JChuy0/CustomClock/images/clock_1.jpg

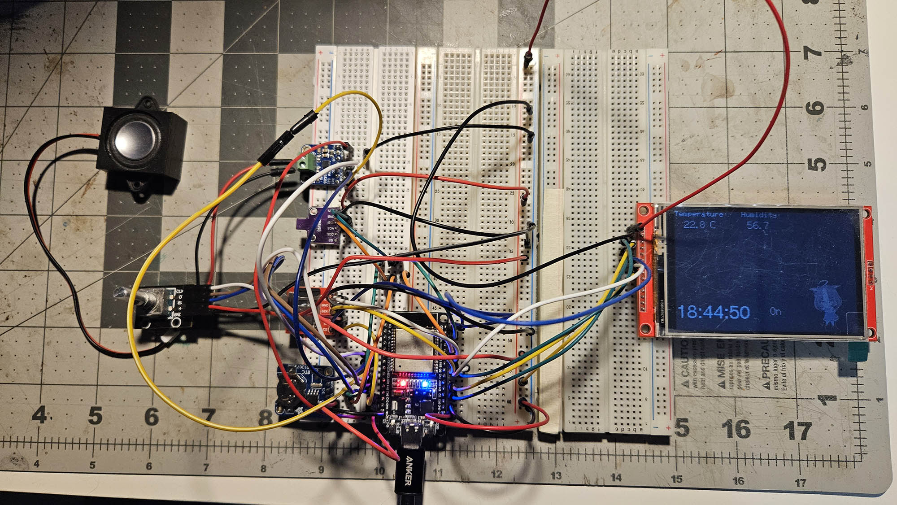
images/clock_1.jpg
