JChuy0/CustomClock/images/clock_flowchart.png

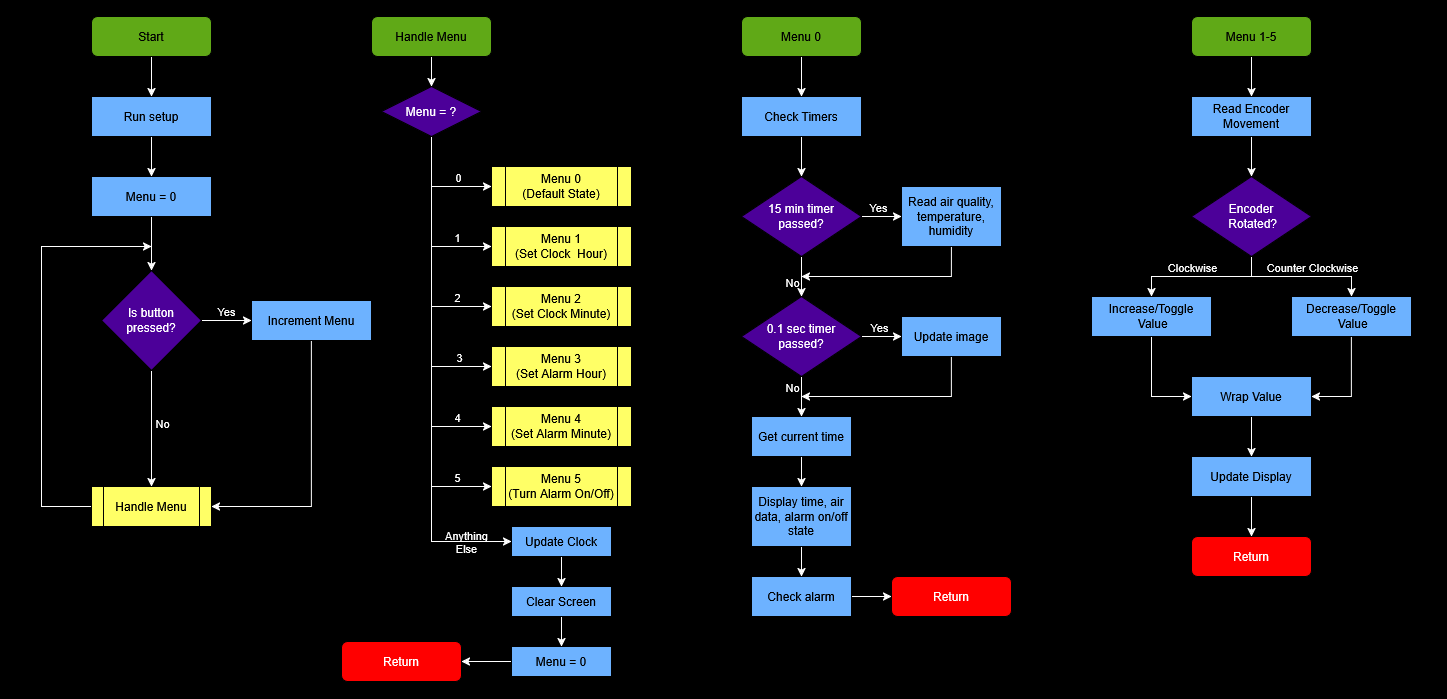
images/clock_flowchart.png
