JChuy0/CustomClock/Bill Of Materials.ods

Sheet: BOM
Digikey Part Number | Manuf Part Number | Part Name | Qty | Voltage | Communication Protocol | Datasheets
N/A |  | ESP-WROOM-32 Dev Board | 1 | 3.3v | N/A
1528-1788-ND | 3296 | Eval Board for DS1307 | 1 | 5v | I2C | https://mm.digikey.com/Volume0/opasdata/d220001/medias/docus/2334/3296_Web.pdf
N/A |  | BME680 | 1 | 3-5v | I2C/SPI | https://www.bosch-sensortec.com/media/boschsensortec/downloads/datasheets/bst-bme680-ds001.pdf
1568-00544-ND | 544 | Sparkfun MicroSD Transflash Breakout | 1 | 3.3v | SPI | https://github.com/sparkfun/microSD_Transflash_Breakout/tree/V_1.4
N/A |  | 3.5” 480x220 LCD Screen ILI9488 | 1 | 3.3v | SPI
1528-1696-ND | 3006 | Eval Board for Max98357A | 1 | 5v | I2S | https://cdn-learn.adafruit.com/downloads/pdf/adafruit-max98357-i2s-class-d-mono-amp.pdf
N/A |  | D-LIFE 3w 8ohm mini speaker | 1 | 3-5v | N/A
Need to add rotary encoder, light sensor, and power source

Sheet: Code Libraries
Name | What’s it for? | URL
ESP8266Audio | Audio Library | https://github.com/earlephilhower/ESP8266Audio
Arduino-esp32 | SD Card Module | https://github.com/espressif/arduino-esp32/tree/master

Sheet: BME680 Reading
Reading started at 11596 and will finish at 11778
You can do other work during BME680 measurement.
Reading completed at 11914
Temperature = 26.48 *C
Pressure = 971.65 hPa
Humidity = 44.73 %
Gas = 15.18 KOhms
Approx. Altitude = 352.08 m

Sheet: Animation Notes
frames
the pointing animation has 7 unique frames
1 2 3 4 5 6 7 6 5 1
get the file path for each image, put them into an array
then calling the display function would display 1 image and increment a counter
when the counter reaches the last element, set it to the first element
To handle the animation, I'm thinking of storing the file path for each frame in an array. Then I have a function to display 1 frame every 100ms, and increment a counter. Once the counter reaches the last element, set it to the first element.
One function loads the file paths for each frame for the given animation.
A second function will display 1 frame and increment a counter

Sheet: Pin Mapping
TFT Screen driver | PIN | Notes
TFT_MISO/CIPO/DO | 19
TFT_MOSI/COPI/DI | 23
TFT_SCLK | 18
TFT_CS | 5 | Chip select control pin
TFT_DC | 2 | Data Command control pin
TFT_RST | 4 | Reset pin
LCD Screen
VCC | 3.3v
GND | gnd
CS | 5
RESET | 4
DC | 2
SDI/MOSI | 23
SCK | 18
LED | 3.3v
SDO/MISO | (not used)
SD card slot
CD | optional
DO | 19
GND | gnd
SCK | 18
VCC | 3.3v
DI | 23
CS | 13
Clock Module
GND | gnd
VCC | 5v
SDA | 21
SCL | 22
SQW | not used
BME680
VCC | 3.3v
GND | gnd
SCL | 22
SDA | 21
SDO | not used
CS | not used
Rotary Encoder
CLK | 26
DT | 27
SW | 14
VCC | 3.3v
GND | gnd
Audio Amp
VIN | 5v | Audio is distorted with 3.3v
GND | gnd
SD | not used
GAIN | not used
DIN | 32
BCLK | 33
LRC | 25
