JChuy0/CustomClock/Problems and Solutions.odt

Clock

Problems and Solutions

UNSOLVED:

new problem

I added 2 animations, one to display when the alarm goes off.

But when I attempt to turn the alarm off, the alarm gives a long beep like it froze up.

Swapping the order between isAlarmRinging and loadAnimation didn't work.

Removing loadanimation removes the issue. But I need change the animation when the alarm stops ringing.

Another issue is that the alarm tune "blocks" other code from running. So the alarm animation doesn't update often enough.

SOLVED:

LCD screen

Setting up the tft screen and getting it working was difficult.

I wired up the lcd screen but it didn’t work.

I found this one video about wiring up the lcd screen. Their hardware was slightly different from mine so I paid close attention to everything. And found out my drivers were not configured to work with my hardware.

Problem: LCD Screen not working.

Cause: LCD screen driver was not configured correctly.

Fix: Configured the driver to work for my hardware.

Animation

Playing an animation “blocks” the clock from updating.

I solved this by rewriting the displayImage to only display 1 frame of the animation. Then update it every 100ms.

SD Card

Wiring up an SD module was surprisingly difficult.

To solve this problem I:

Ran the code through a simulator. It worked as expected.

Verified my wiring several times

Swapped every part and wire to ensure I wasn’t using a defective part.

Asked for help on a the Arduino community discord.

None of those solved the problem.

Problem: SD module wouldn’t work.

Cause: Using pin 5 for chip select. 5 doesn’t work reliably because it’s a strapping pin, used when booting up the micro controller.

Fix: Use a different (non strapping) pin, like pin 13 for the chip select.

What made this difficult to diagnose, is that pin 5 is the default/standard pin for chip select. So it should work. And it does work for some components. But not for the SD card module.

SD Wiring

I wired up a SD card module to an esp32 and it works. Then I tried adding an SD card to my existing project but it wouldn’t work for some reason. I checked my wiring and disconnected all other components. It still didn’t work. After some testing, I found the issue was a faulty breadboard rail.

Problem: SD module isn’t working.

Cause: Faulty breadboard rail

Fix: Use a different section of the breadboard or a different breadboard.

Images Won’t Display

Originally, I did have image display working using code examples from the ‘TFT eSPI’ and PNGdec libraries. Sometime later the images stopped being displayed even though my code hasn’t changed.

To troubleshoot this, I opened the ‘sdcard_slideshow’ example from the PNGdec library. Changed the bare minimum code so that it works with my hardware. Looked for any differences between this example and my project code. I removed 2 lines from my project code that weren’t in the example and this fixed the problem. The images are now displayed.

Problem: Images won’t display on screen

Cause: Turns out the issue was caused by an update to the ‘TFT eSPI’ library.

Fix: Removing ‘tft.startWrite()’ and ‘tft.endWrite()’ from my code fixed the issue.

Distorted Audio

Turns out it was a code issue caused by polling the clock module too often.

Originally I thought it was a power issue because both the audio amp and the clock module (RTC) are on the 5v pin. I made sure all components were getting enough power and even tried adding a capacitor to the amp, but the issue remained.

Then I wondered if it was a code issue. So, I took a code example where the audio worked perfectly and added the clock module. The audio became distorted.

After some logging, I noticed the clock was updating several times per second. I edited the code to update the clock every 7 seconds. No distortion. I lowered it to 3 seconds, then 1 second. Still no distortion.

So, the CPU couldn’t keep up with the constant clock updates while also playing audio.

Problem: Audio is distorted

Cause: Clock module was updating several times per second, which is too often.

Fix: Reduced the frequency of the updates to once per second.
