JChuy0/CustomClock/CustomClock/AirSensor.h

#ifndef AIR_SENSOR_H
#define AIR_SENSOR_H

#include "Data_Types.h"
#include <Adafruit_BME680.h>

// struct BME680Data {
//   float temperature;
//   float humidity;
//   // float pressure; 
//   // float gasResistance;
// };

void setupBME680();
BME680Data readBME680();

#endif
