JChuy0/CustomClock/(commit log)

2025-12-28 Rewrote program.
    LCD screen displays current time. Now rotary encoder can be used to change the time.
2026-01-01 Implemented Alarm
    An alarm will start buzzing when the set time is reached. The buzzing can be stopped by pressing the encoder button.
    [CustomClock.ino]
2026-01-28 Changed microcontroller and LCD screen
    Changed the micro controller from an arduino uno to an esp32. I also changed the LCD screen from a basic 2 line screen to a 3.5 inch full color screen.
2026-02-04 Implemented BME680 sensor and adjusted screen layout
    I implemented the BME680 sensor to display the temperature and humidity on the LCD screen. Adjusted the layout of the time and BME680 data on LCD screen. Added a speaker.
2026-02-20 imageDisplay no longer blocks the program
    Previously the program would freeze up while the animation plays. That no longer happens.
    [CustomClock.ino, Display.cpp, Display.h]
2026-05-19 Replaced LittleFS with SD Card
    [AirSensor.cpp, CustomClock.ino, Display.cpp, Display.h, SDCard.cpp]
2026-05-19 Added documents
    I added 2 documents, first the Bill of Materials, which contains info about the parts used and how they are wired. Second is Problems and Solutions, where I document any major issues I encountered in the project and how I solved them.
    [Bill Of Materials.ods]
2026-05-26 Updated Alarm and BOM
    Alarm now plays a MP3 file instead of beeping. Also updated the pin mapping for the Audio Amp.
    [Bill Of Materials.ods]
2026-07-19 Fixed audio distortion
    I fix the audio distortion by pausing the animation while audio is running and by updating the clock less often.
    [AirSensor.cpp, AirSensor.h, Alarm.cpp, Alarm.h, Clock.h, CustomClock.ino, Display.cpp, Display.h]
2026-07-21 Improved audio and changed animation
    Fixed an issue where turning the alarm off while the mp3 played, caused the mp3 to freeze up. Also changed the animation.
    [Alarm.cpp, Clock.cpp, Clock.h, CustomClock.ino, Display.cpp, Display.h]
